jaemyoun/CurrentSensor/currentsensor-core/R1/hardware/currentsensor-core-R1-schematics.pdf

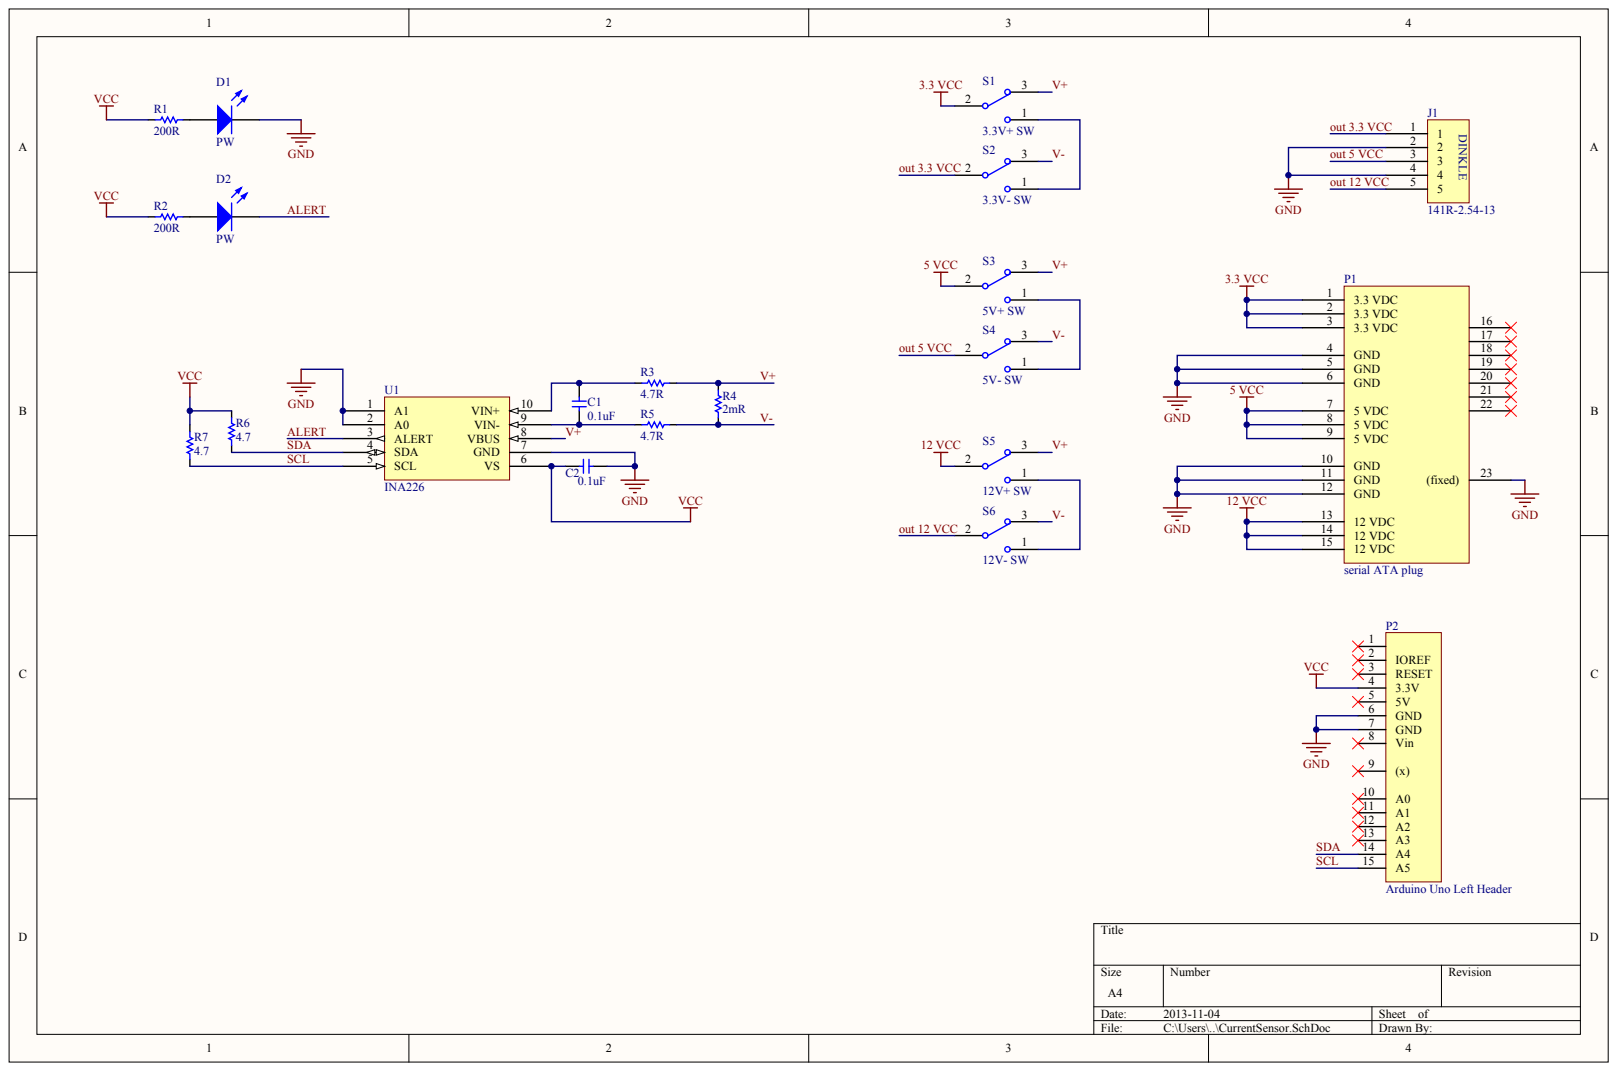
[picture p9: page 1]

GND 5
GND 6

Arduino Uno Left Header
