jaemyoun/CurrentSensor/currentsensor-core/R2/hardware/currentsensor-core-R2-schematics.pdf

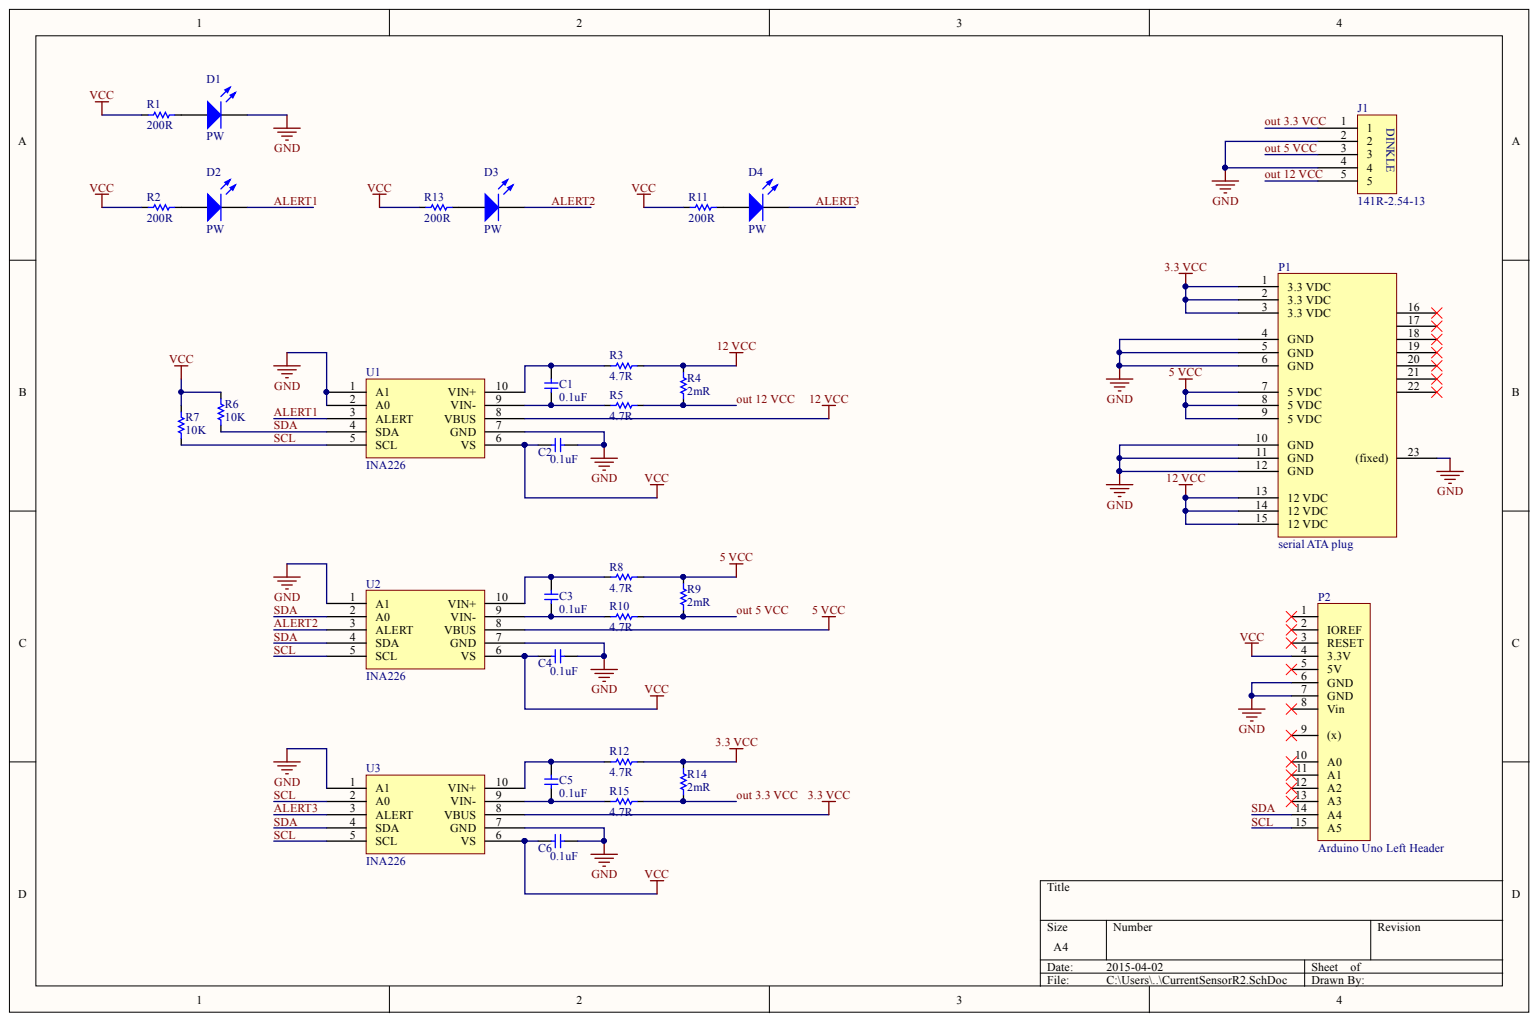
[picture p10: page 1]

Arduino Uno Left Header
