jaemyoun/CurrentSensor/controller-shield/src/controller-shield-schematics.pdf

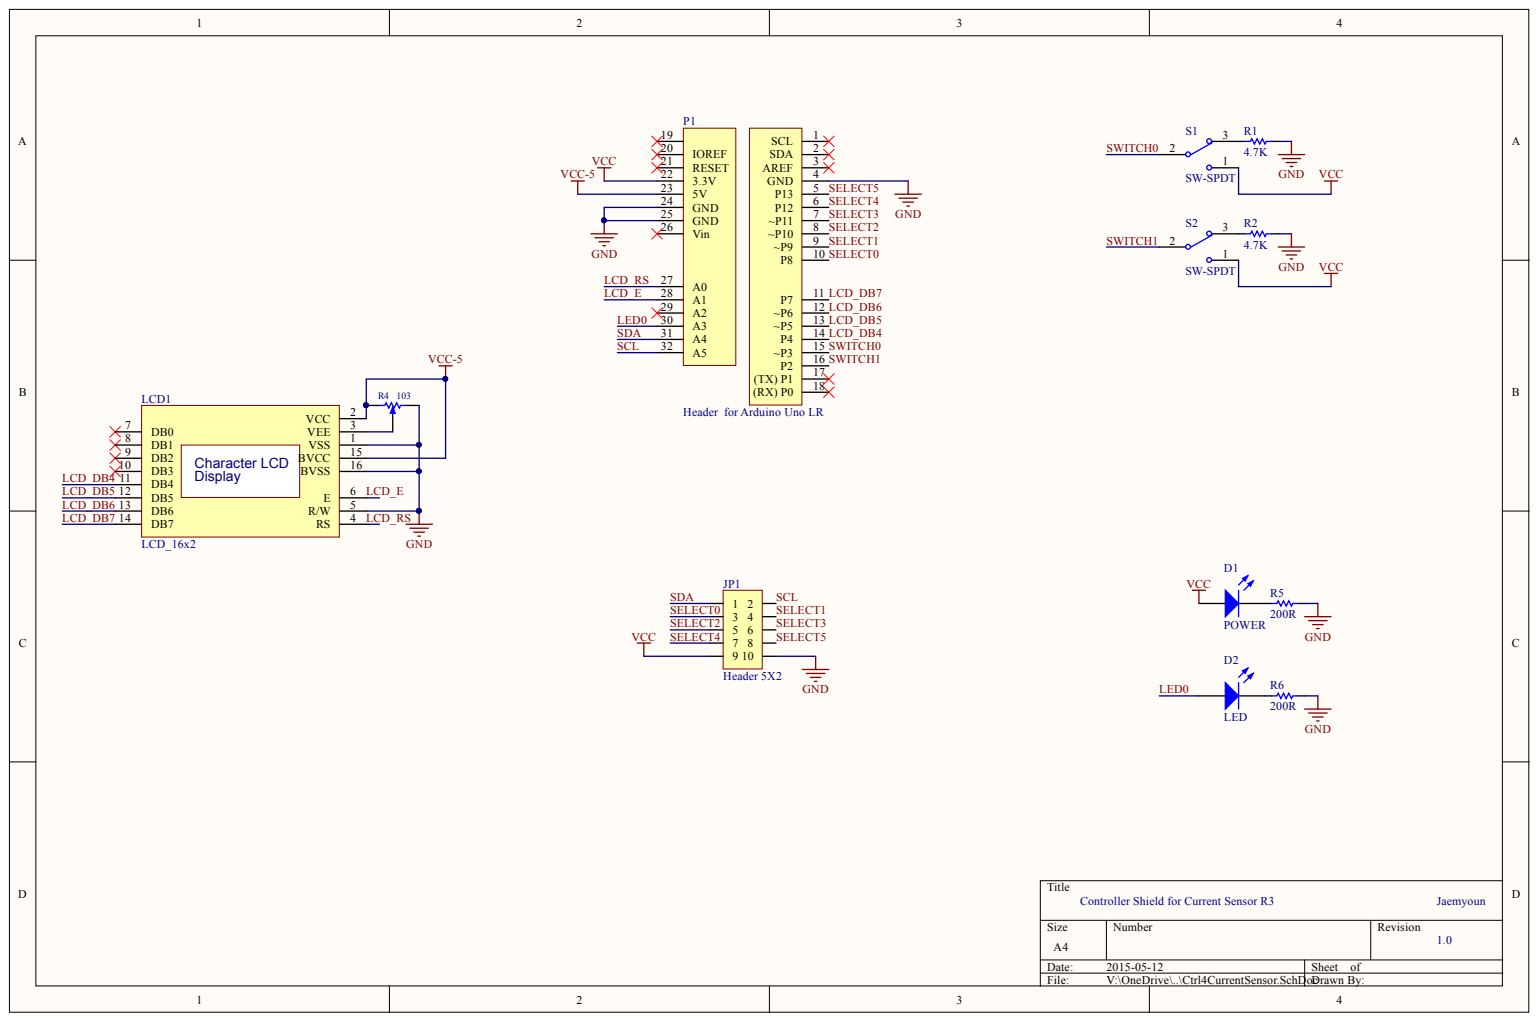
[picture p11: page 1]
