jaemyoun/CurrentSensor/currentsensor-core/R3/hardware/currentsensor-core-R3-schematics.pdf

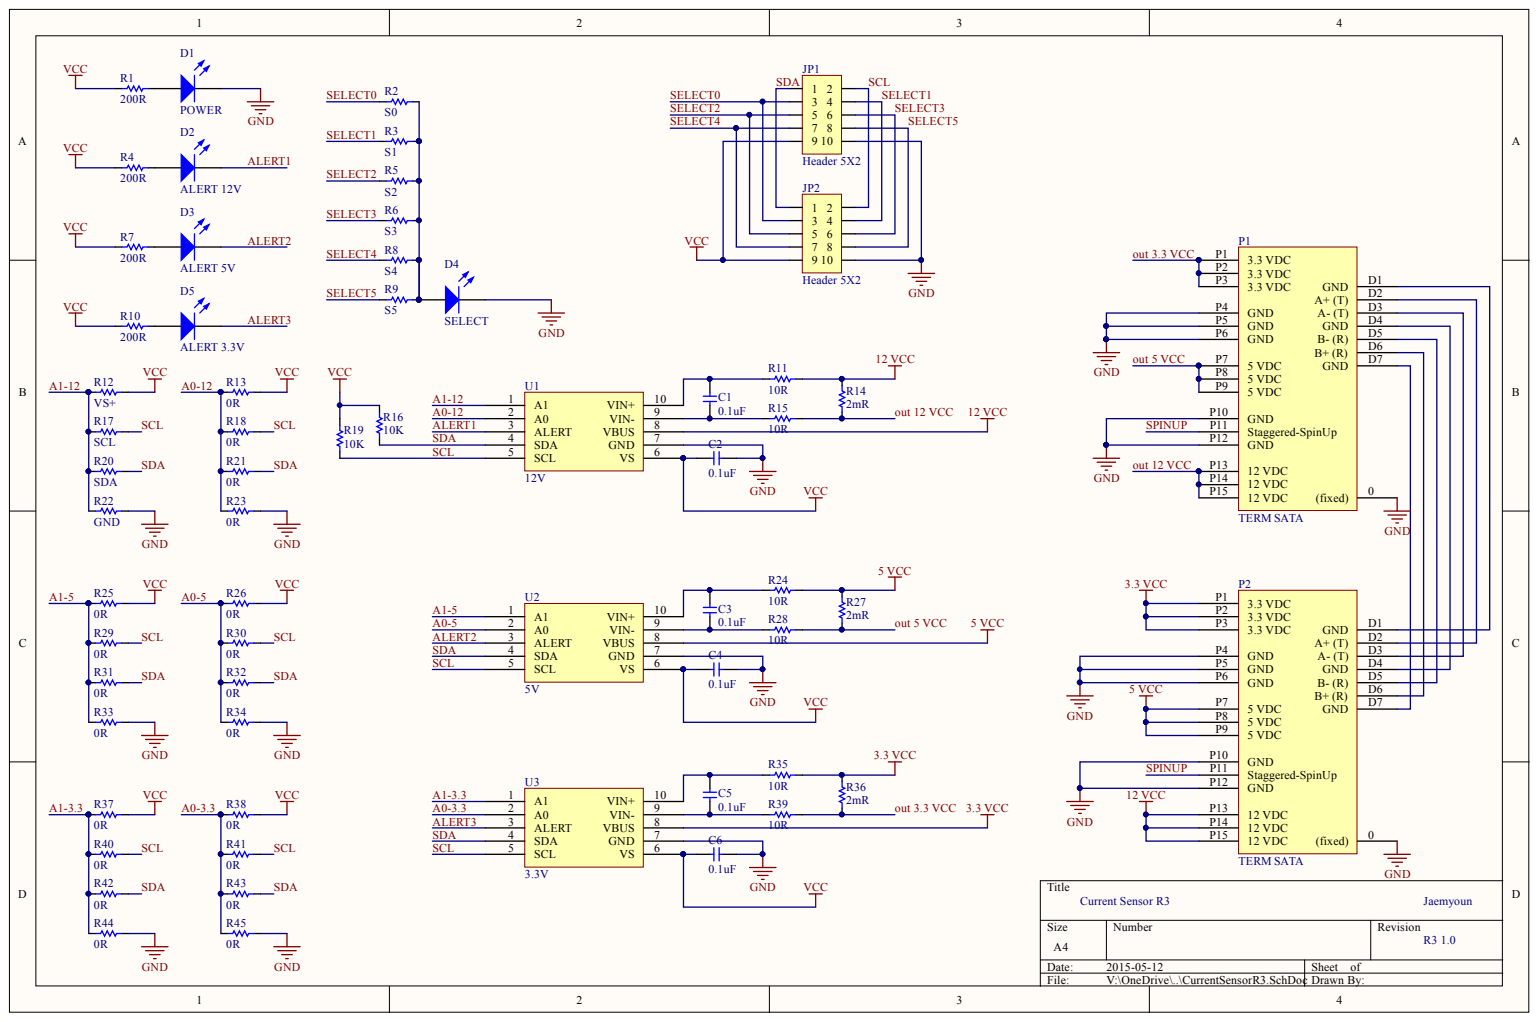
[picture p12: page 1]
