jaemyoun/CurrentSensor/(commit log)

2015-03-22 Create Controller sources
    Ctrl4CS.ino is a source for controller by Arduino
    INA mapping.doc is a mapping table for INA I2C ID.
2015-03-22 Create CurrentSensorR3 artwork files
    [CurrentSensorR3.GBL, CurrentSensorR3.GBO, CurrentSensorR3.GBP, CurrentSensorR3.GBS, CurrentSensorR3.GM1, CurrentSensorR3.GTL, CurrentSensorR3.GTO, CurrentSensorR3.GTP]
2015-04-02 Modify CurrentSensor R3 hardware files
    [CurrentSensorR3.GBL, CurrentSensorR3.GBO, CurrentSensorR3.GBP, CurrentSensorR3.GBS, CurrentSensorR3.GM1, CurrentSensorR3.GTL, CurrentSensorR3.GTO, CurrentSensorR3.GTP]
2015-04-02 Create CurrentSensor R1 & R2
2015-04-02 Rename schematics files
2015-05-11 Add Switch function & change pin configurations
2015-05-12 Update Readme.md about inserting images
2015-05-12 Modify CurrentSensor R3
2015-05-12 Rename currentsensor-core-R1-NCDrill
2016-10-02 enable for power measurement expr.
2016-12-16 edited 12v printing
