jaemyoun/CurrentSensor/(notices)

Notices in the files:
controller-shield/src/Ctrl4CS/INA226.cpp:
This program is free software: you can redistribute it and/or modify
it under the terms of the version 3 GNU General Public License as
published by the Free Software Foundation.
